rusucc/WRO_003_Robotics/Pi/Cod/docs/WRO.png

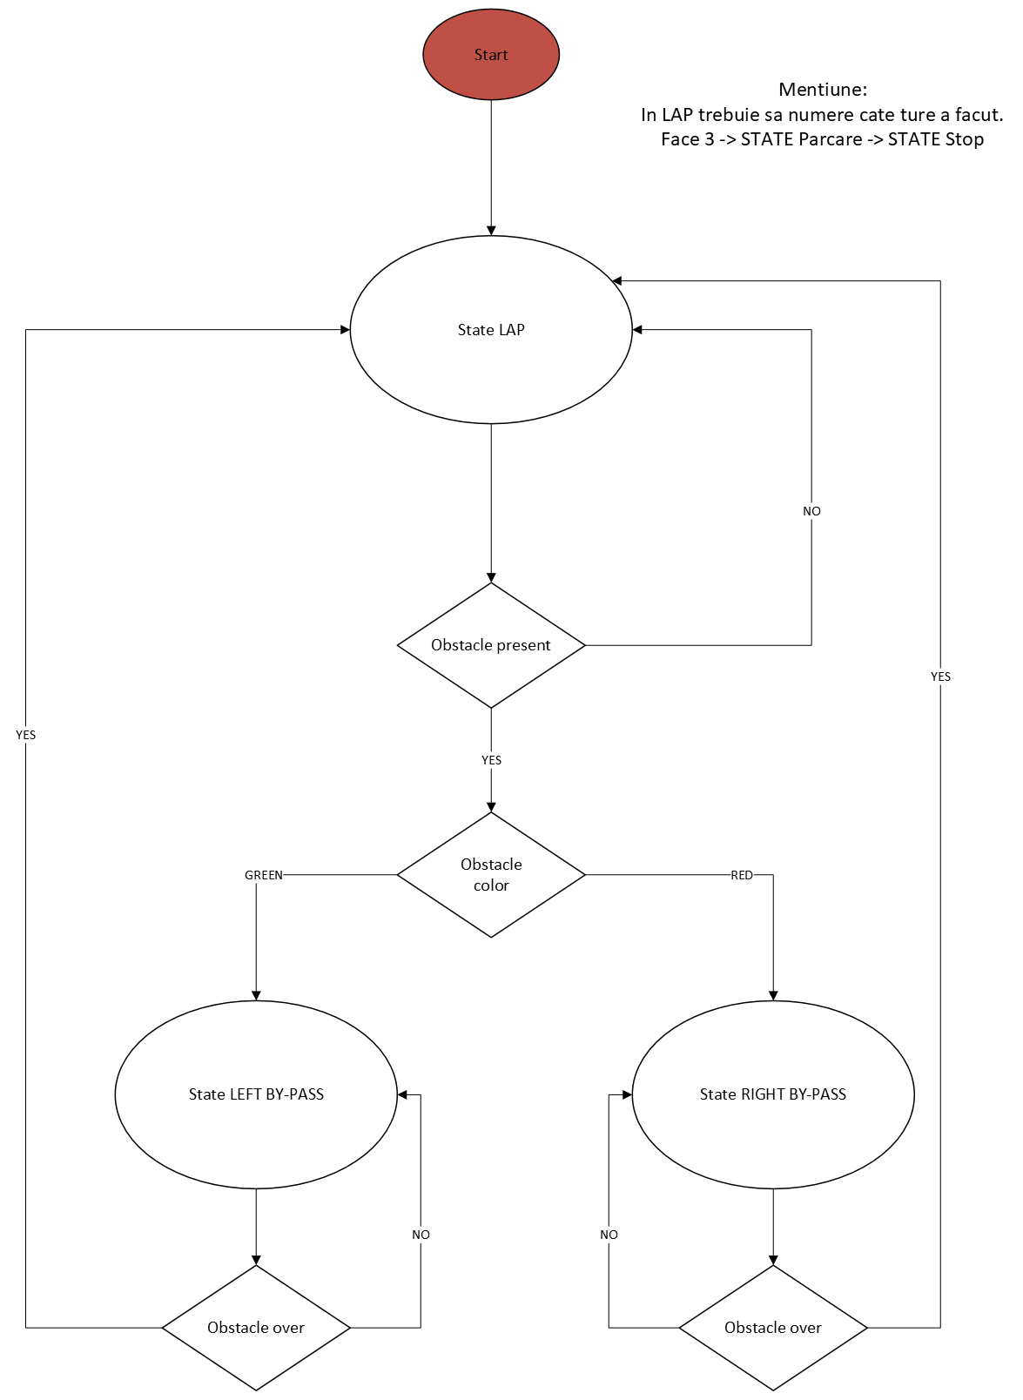
Pi/Cod/docs/WRO.png
