rusucc/WRO_003_Robotics/Poze/Block diagram.jpeg

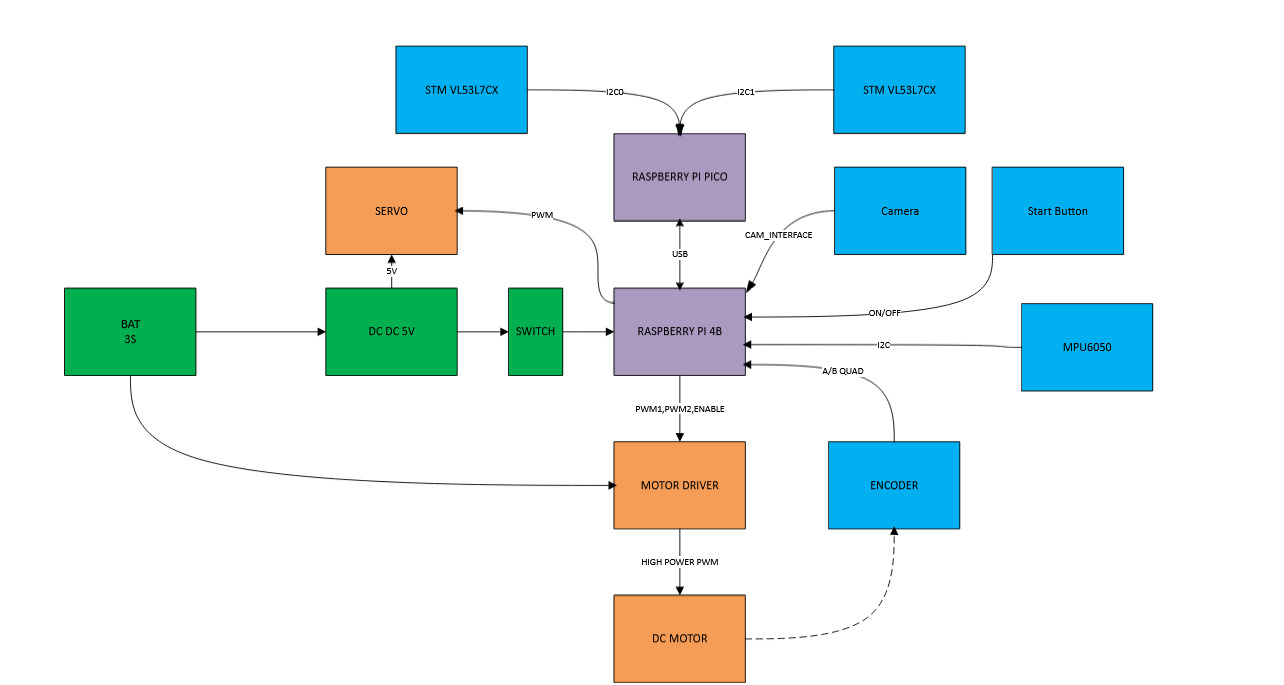
Poze/Block diagram.jpeg
