rusucc/WRO_003_Robotics/Poze/cam1.jpg

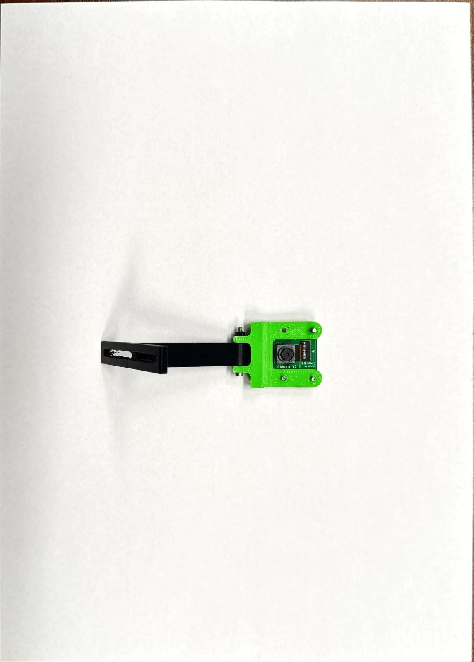
Poze/cam1.jpg
