rusucc/WRO_003_Robotics/Poze/cam2.jpg

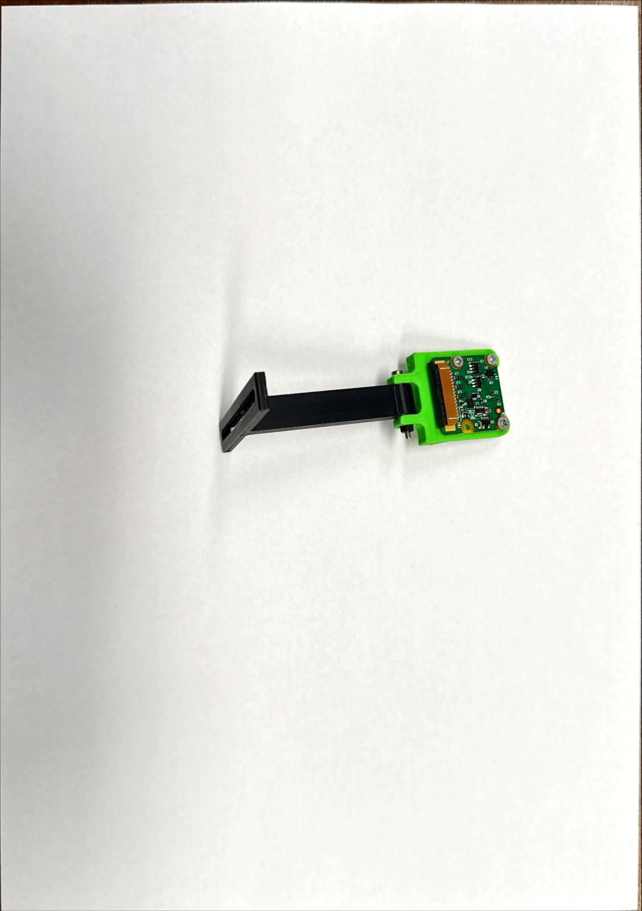
Poze/cam2.jpg
