rusucc/WRO_003_Robotics/Pico/Hardware/PCB_WRO_003_2025-06-09.pdf

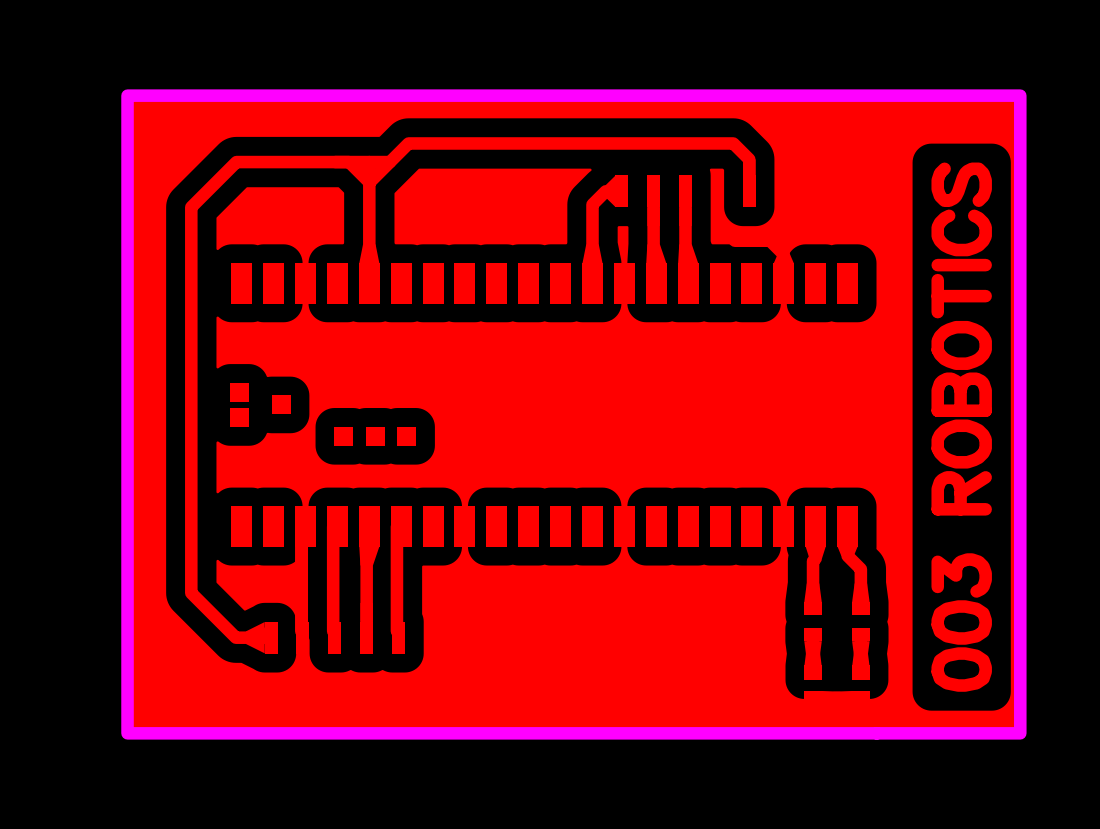
[picture p17: page 1]
