rusucc/WRO_003_Robotics/Pico/Hardware/Schematic_WRO_003_2025-06-09.pdf

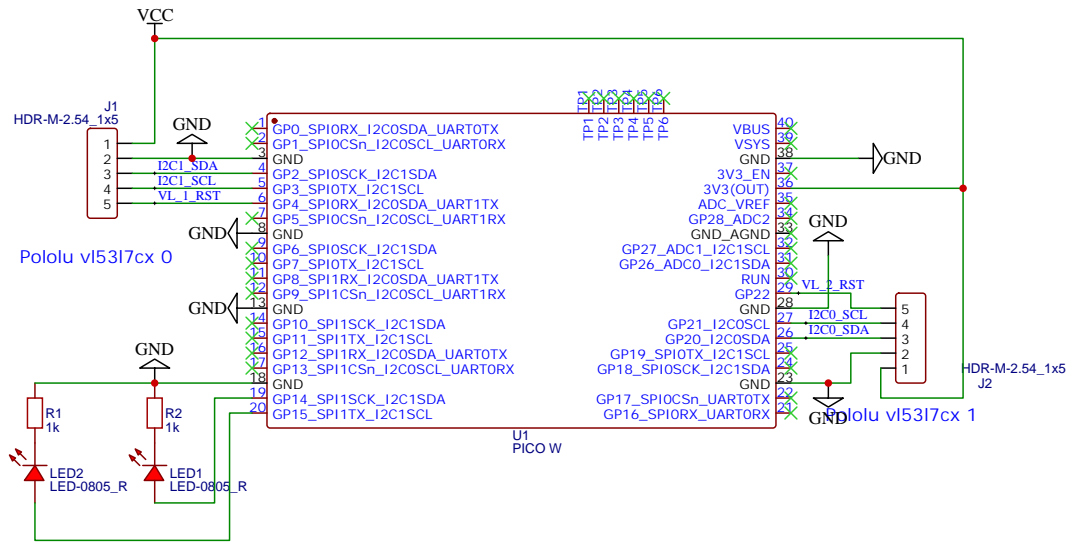
[picture p18: page 1]
