rusucc/WRO_003_Robotics/(commit log)

2025-06-08 First commit, added Pi Pico files
2025-06-08 Added ECAD files for Pico carrier board for ToF sensors
2025-06-09 commit initial PI - am inceput FSM ul, trebuie sa implementam functiile de miscare in mod prioritar
    [pyvenv.cfg]
2025-06-09 am mutat in cod
    [pyvenv.cfg]
2025-06-09 am mutat in src modulele
    [pyvenv.cfg]
2025-06-11 added manufacturing pics
    [pyvenv.cfg]
