rusucc/WRO_003_Robotics/Pico/Hardware/IMG_20250608_163540299_HDR.jpg

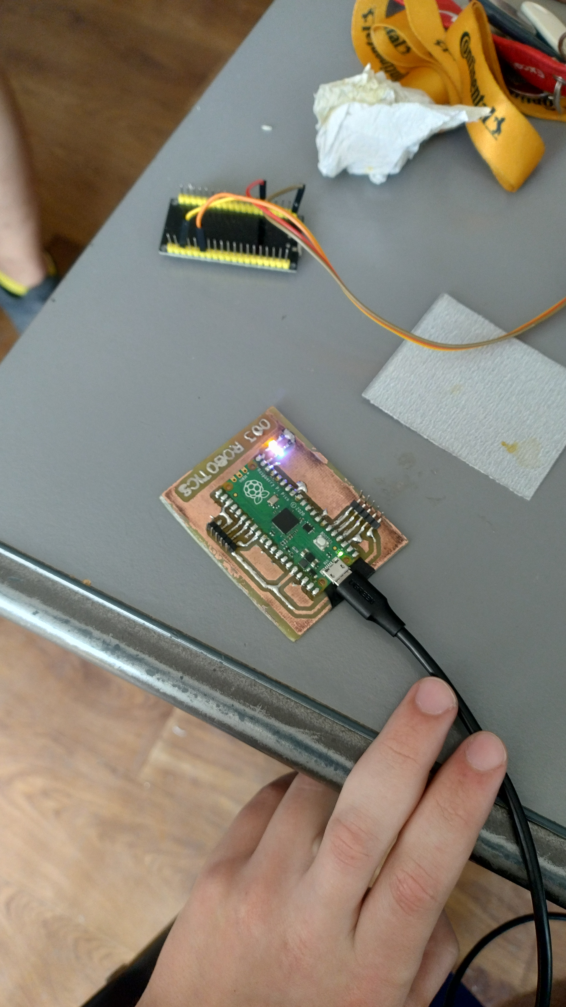
Pico/Hardware/IMG_20250608_163540299_HDR.jpg
